LaosLaser/AddOns/i2c-panel/pictures/panel-laos-hardware.png

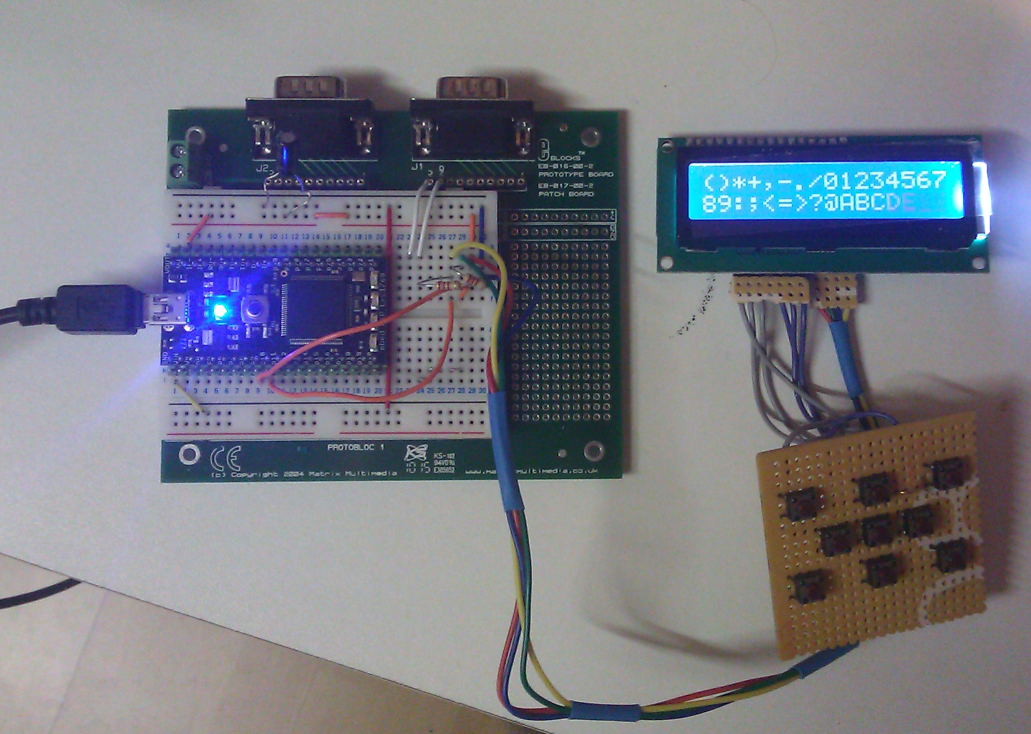
i2c-panel/pictures/panel-laos-hardware.png
