LaosLaser/AddOns/i2c-panel/Datasheets/ATTiny2313/schematic.jpg

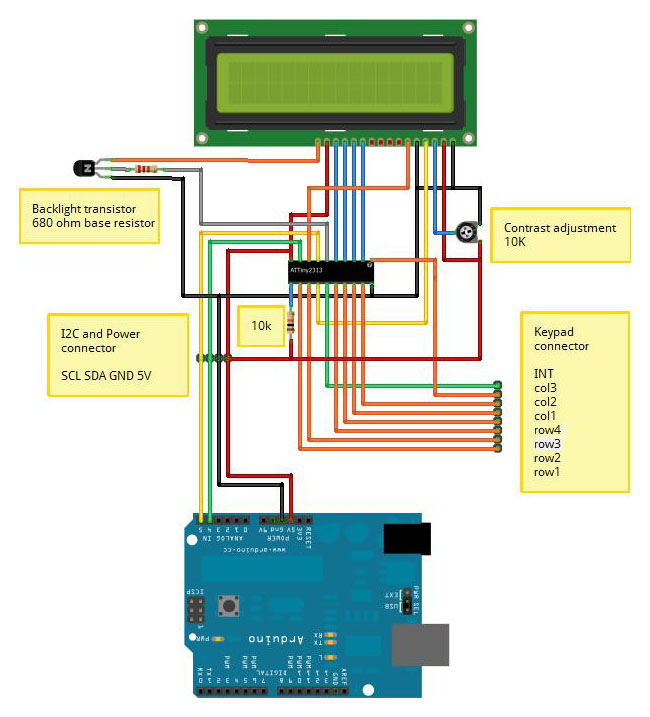
i2c-panel/Datasheets/ATTiny2313/schematic.jpg
