LaosLaser/AddOns/i2c-panel/firmware/README.txt

In this directory:

I2C-panel-test.cpp		Test program for I2C communication from
				MBED to Arduino and vice-versa.
				The MBED is master.
lasercutterpanel.pde		Arduino program implementing:
				* I2C slave
				* 16x2 LCD
				* 6 Button keyboard
				Getest op Arduino Duemilanove
