LaosLaser/AddOns/i2c-panel/pcb-0.4/production/PI_E545252.pdf

E545252 PCB view TOP (topview)

E545252 TOP layer Image (topview)

E545252 BOTTOM layer Image (topview)

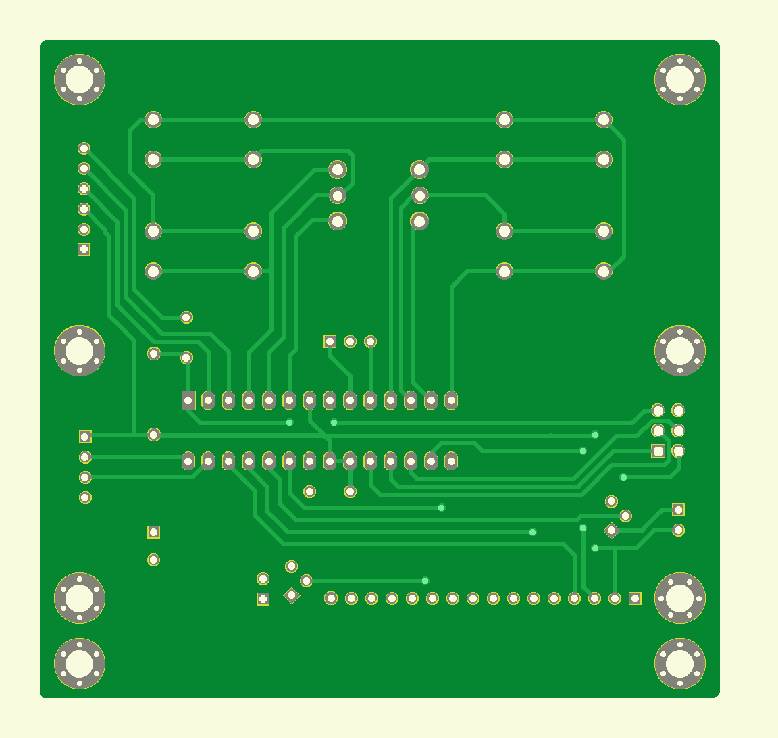
[picture p3: page 4]

E545252 PCB view BOTTOM (bottomview)

# E545252 PCB Mechanical view (topview)

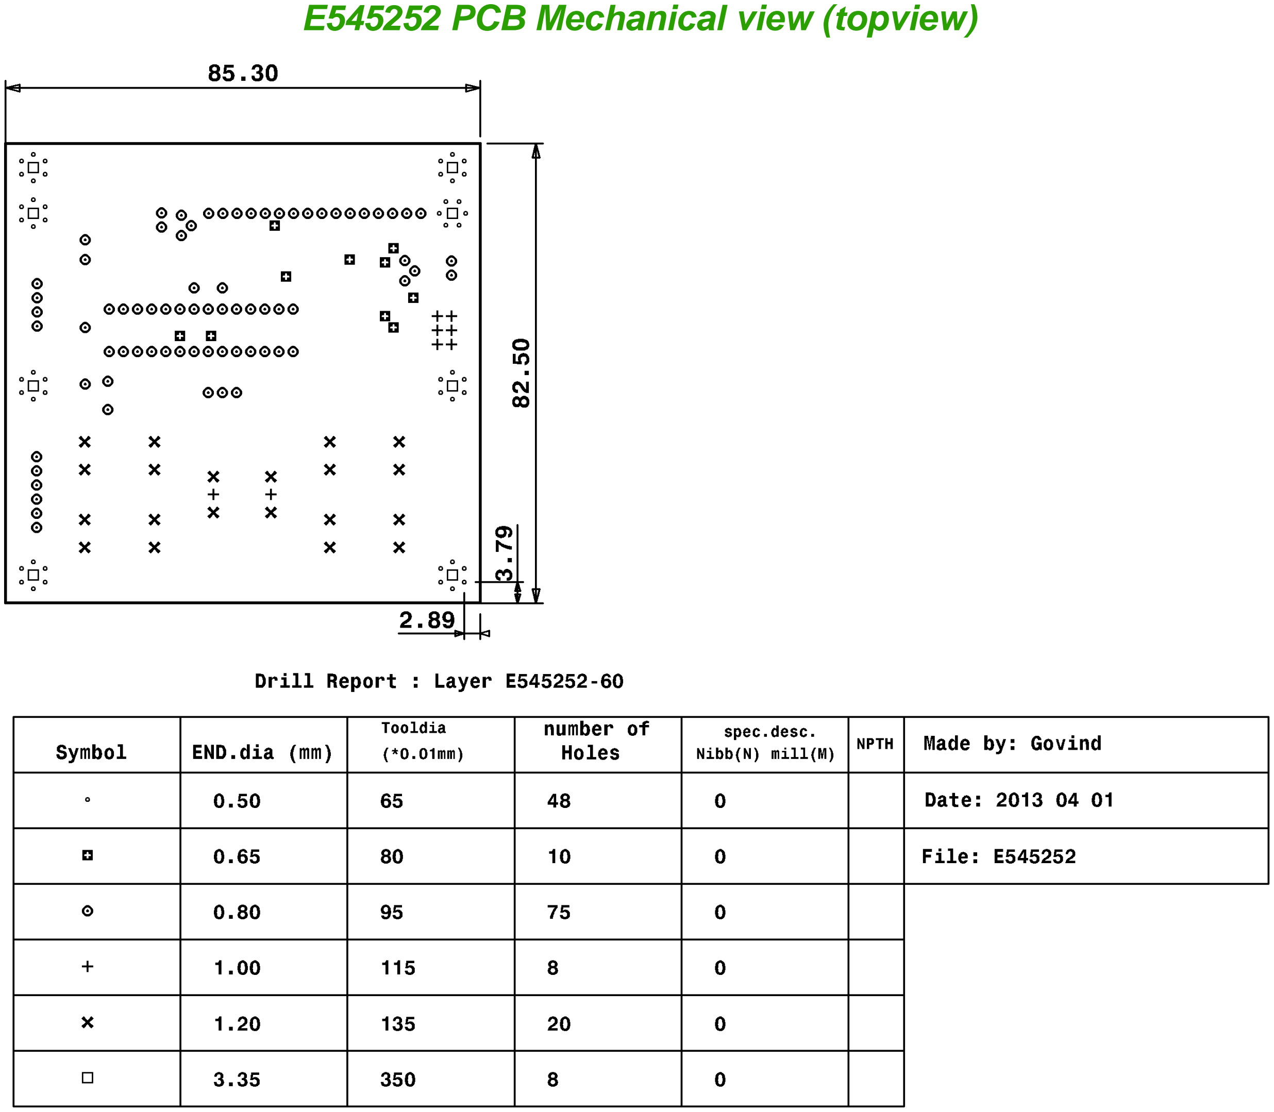
[picture p4: page 5]
