LaosLaser/AddOns/i2c-panel/pictures/panel-2011-07-01.jpg

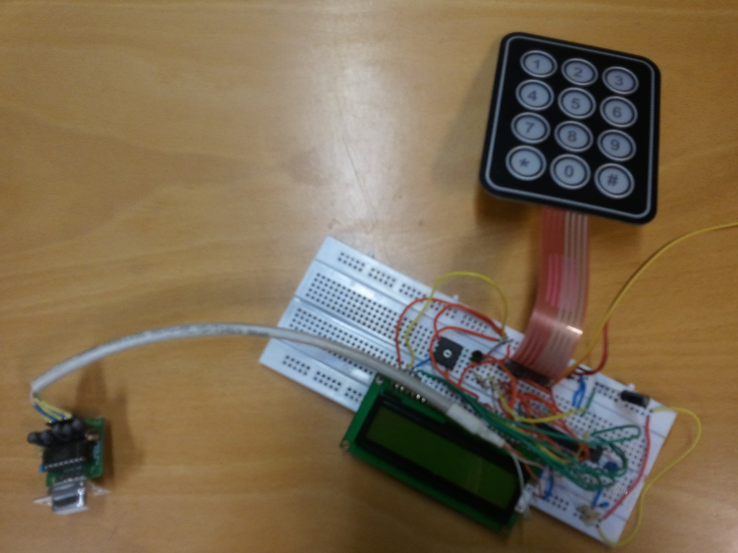
i2c-panel/pictures/panel-2011-07-01.jpg
