LaosLaser/AddOns/i2c-panel/pictures/panel-2011-07.jpg

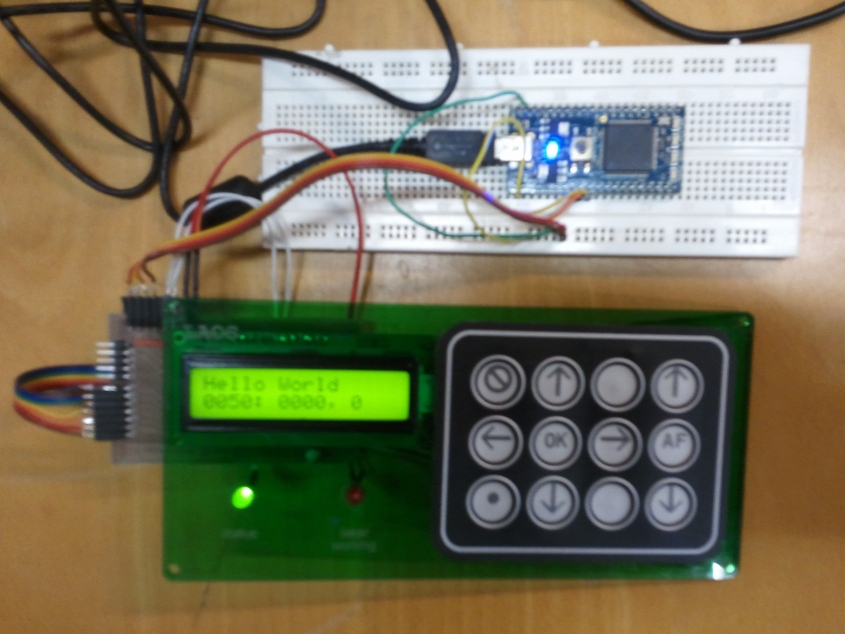
i2c-panel/pictures/panel-2011-07.jpg
