LaosLaser/AddOns/i2c-panel/pictures/panel-epilog.jpg

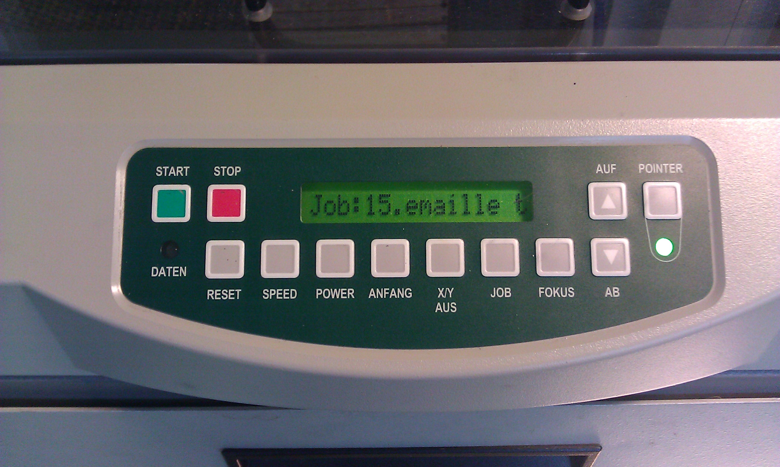
i2c-panel/pictures/panel-epilog.jpg
