LaosLaser/AddOns/i2c-panel/pictures/panel-hpc.jpg

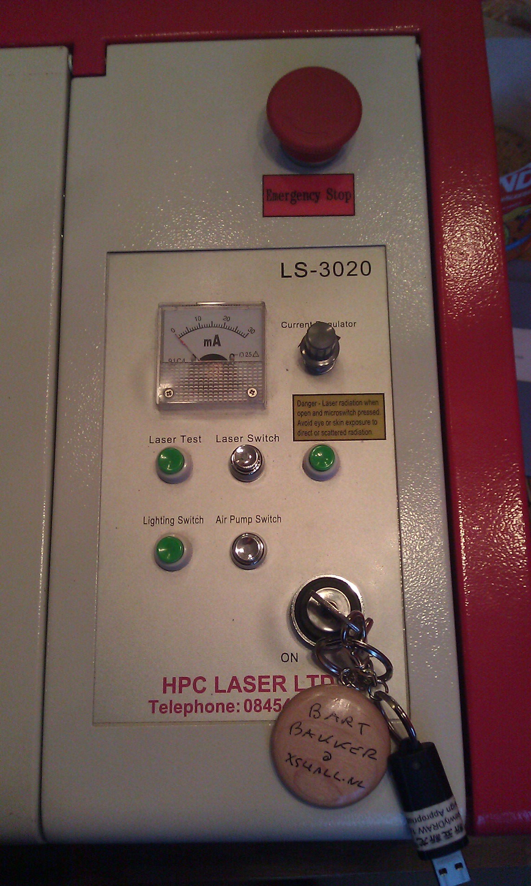
i2c-panel/pictures/panel-hpc.jpg
