LaosLaser/AddOns/i2c-panel/pictures/panel-laos.png

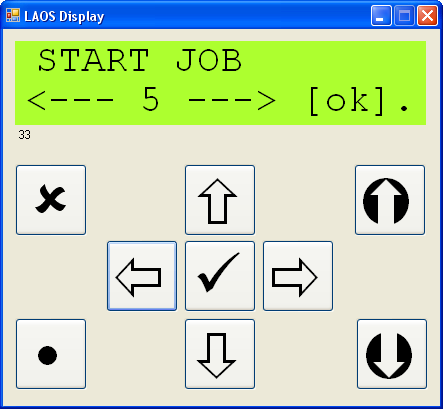
i2c-panel/pictures/panel-laos.png
