LaosLaser/AddOns/i2c-panel/pictures/panel-rev0.2.png

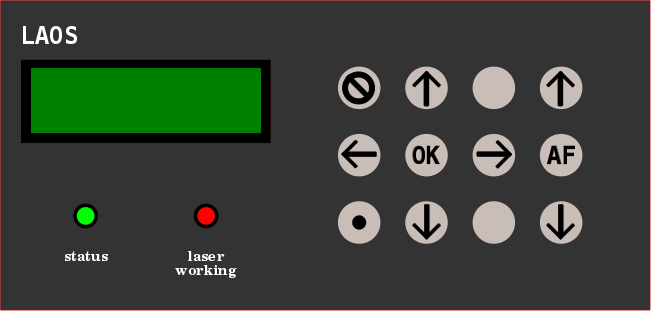
i2c-panel/pictures/panel-rev0.2.png
