LaosLaser/AddOns/i2c-panel/pictures/panel-spiritgx.jpg

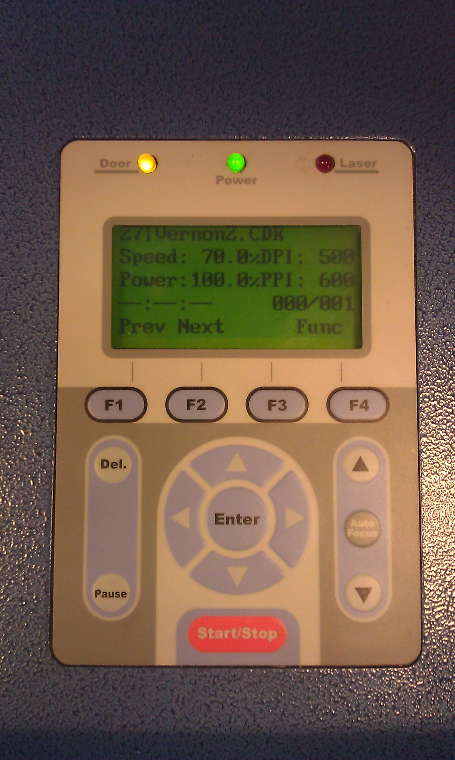
i2c-panel/pictures/panel-spiritgx.jpg
