LaosLaser/AddOns/i2c-panel/pictures/panel-suda.jpg

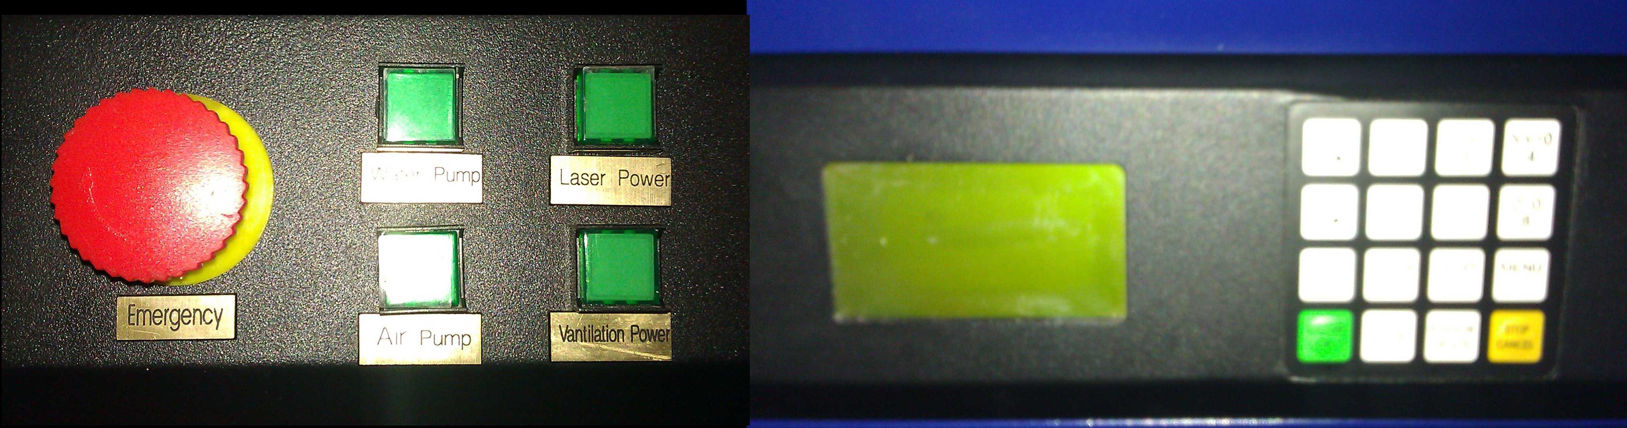
i2c-panel/pictures/panel-suda.jpg
