LaosLaser/AddOns/i2c-panel/pictures/rev0.3_prototype/IMG_20111130_150810.jpg

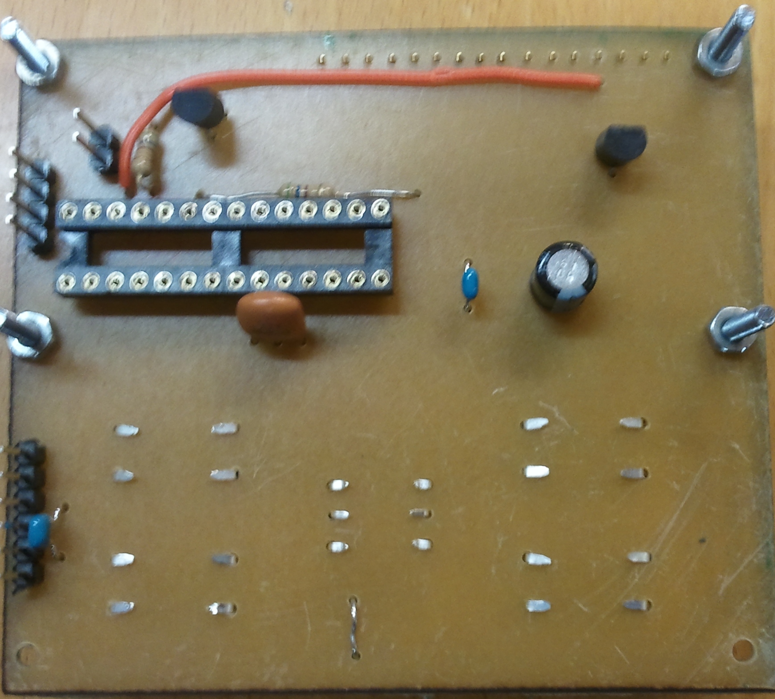
i2c-panel/pictures/rev0.3_prototype/IMG_20111130_150810.jpg
