LaosLaser/AddOns/i2c-panel/pcb-0.4/bom.ods

# | Bill of materials, I2C Panel rev0.4 | Part | Shop | Order nr | PPS | Tot
1 | LCD display, 16x2 characters | U3 | RS Components | 532-6408 | 4.62 | 4.62
1 | ATMega168P-20PU | IC1 | RS Components | 738-0375 | 5.22 | 5.22 | Farnell: 1661728: 2,45/stuk!
4 | Thru hole tactileswitch12x12x7.3mm | SW1-4 | RS Components | 378-6763 | 0.46 | 1.84
1 | PCB Stick switch, 4 dir + centre push | SW5 | RS Components | 516-316 | 2.25 | 2.25
1 | Ceramic resonator THT CSTLS 16.00MHz | F1 | RS Components | 526-6154 | 0.56 | 0.56
1 | 28way low profile DIL socket,0.3in pitch | IC1 | RS Components | 801-768 | 0.24 | 0.24
2 | 100uF capacitor | U2 | RS Components | 711-0703 | 0.03 | 0.06
2 | 100nF capacitor | U1,U4 | RS Components | 721-5240 | 0.07 | 0.14
1 | 10K resistor | R2 | RS Components | 707-7745 | 0.02 | 0.02
1 | 36 way straight header,7mm top 3mm below |  | RS Components | 251-8632 | 0.31 | 0.31
2 | BS270 | Q1, Q4 | Farnell | 1017689 | 0.149 | 0.298
1 | Kingstate KPEG242 buzzer | P3 | Farnell | 1502726 | 2.03 | 2.03 | of RS: 535-8253
3 | plastic buttoncap black |  | RS Components | 378-6943 | 0.11 | 0.33
1 | plastic buttoncap red |  | RS Components | 378-6937 | 0.11 | 0.11
1 | Eurocircuits PCB |  | Eurocircuits | E412106 | 7.5 | 7.5
 |  |  |  |  |  | 25.528
 | BTW |  |  |  |  | 30.88888
