LaosLaser/AddOns/i2c-panel/pcb-0.4/panel.sch

## KiCad design i2c-panel/pcb-0.4/panel.sch (2013-04-17)

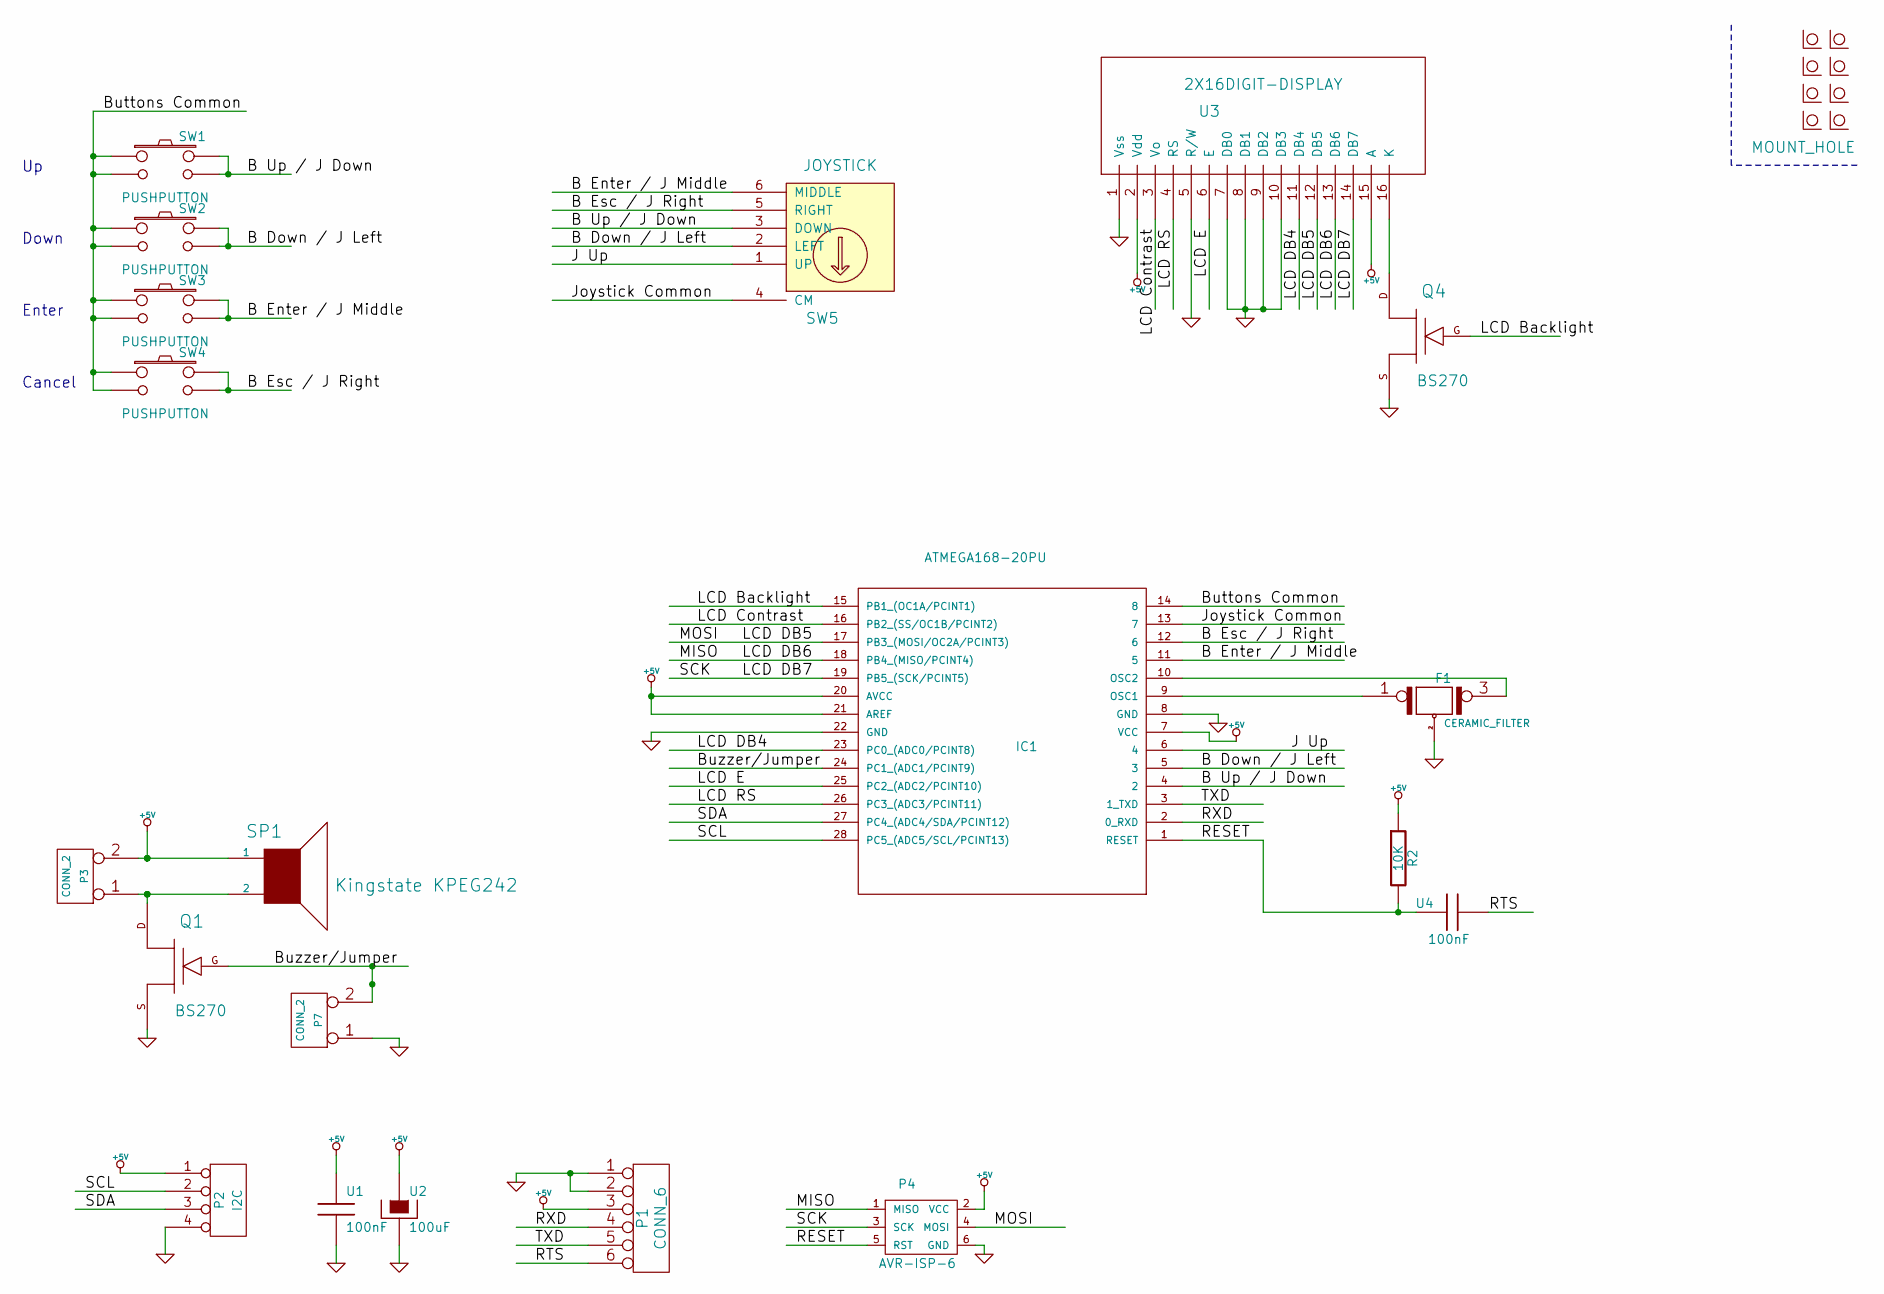
[picture p17: schematic panel.sch]

Parts:
F1: CERAMIC_FILTER; SIL-3
H1, H2, H3, H4, H5, H6, H7, H8: MOUNT_HOLE; HOLE_3MM
IC1: ATMEGA168-20PU; DIP-28__300_ELL
P1: CONN_6; SIL-6
P2: I2C; SIL-4
P3: CONN_2; SIL-1
P4: AVR-ISP-6; SIL-1
P7: CONN_2; SIL-2
Q1, Q4: BS270; TO92DGS
R2: 10K; R4
SP1: Kingstate KPEG242; KPEG242
SW1, SW2, SW3, SW4: PUSHPUTTON; PUSHBUTTON
SW5: JOYSTICK; JOYSTICK_FLIPPED_RIGHT
U1, U4: 100nF; C2
U2: 100uF; CCAP_3.5MM
U3: 2X16DIGIT-DISPLAY; SIL-16

Connections:
+5V: IC1.7 (VCC), IC1.20 (AVCC), IC1.21 (AREF), P1.3, P2.1, P3.2 (PM), P4.2 (VCC), R2.1, SP1.1, U1.1, U2.1, U3.2 (Vdd), U3.15 (A)
B Down / J Left: IC1.5 (3), SW2.3, SW2.4, SW5.2 (LEFT)
B Enter / J Middle: IC1.11 (5), SW3.3, SW3.4, SW5.6 (MIDDLE)
B Esc / J Right: IC1.12 (6), SW4.3, SW4.4, SW5.5 (RIGHT)
B Up / J Down: IC1.4 (2), SW1.3, SW1.4, SW5.3 (DOWN)
Buttons Common: IC1.14 (8), SW1.1, SW1.2, SW2.1, SW2.2, SW3.1, SW3.2, SW4.1, SW4.2
Buzzer/Jumper: IC1.24 (PC1_(ADC1/PCINT9)), P7.2 (PM), Q1.G
GND: F1.2 (PM), IC1.8 (GND), IC1.22 (GND), P1.1, P1.2, P2.4, P4.6 (GND), P7.1, Q1.S, Q4.S, U1.2, U2.2, U3.1 (Vss), U3.5 (R/W), U3.7 (DB0), U3.8 (DB1), U3.9 (DB2), U3.10 (DB3)
J Up: IC1.6 (4), SW5.1 (UP)
Joystick Common: IC1.13 (7), SW5.4 (CM)
LCD Backlight: IC1.15 (PB1_(OC1A/PCINT1)), Q4.G
LCD Contrast: IC1.16 (PB2_(SS/OC1B/PCINT2)), U3.3 (Vo)
LCD DB4: IC1.23 (PC0_(ADC0/PCINT8)), U3.11 (DB4)
LCD DB5: IC1.17 (PB3_(MOSI/OC2A/PCINT3)), P4.4 (MOSI), U3.12 (DB5)
LCD DB6: IC1.18 (PB4_(MISO/PCINT4)), P4.1 (MISO), U3.13 (DB6)
LCD DB7: IC1.19 (PB5_(SCK/PCINT5)), P4.3 (SCK), U3.14 (DB7)
LCD E: IC1.25 (PC2_(ADC2/PCINT10)), U3.6 (E)
LCD RS: IC1.26 (PC3_(ADC3/PCINT11)), U3.4 (RS)
unnamed: F1.1, IC1.9 (OSC1)
unnamed: F1.3, IC1.10 (OSC2)
unnamed: P3.1, Q1.D, SP1.2
unnamed: Q4.D, U3.16 (K)
RESET: IC1.1 (RESET), P4.5 (RST), R2.2, U4.1
RTS: P1.6, U4.2
RXD: IC1.2 (0_RXD), P1.4
SCL: IC1.28 (PC5_(ADC5/SCL/PCINT13)), P2.2
SDA: IC1.27 (PC4_(ADC4/SDA/PCINT12)), P2.3
TXD: IC1.3 (1_TXD), P1.5

Notes on the sheet:
Down
Enter
Cancel
