LaosLaser/AddOns/i2c-panel/pcb/panel.sch

## KiCad design i2c-panel/pcb/panel.sch (2011-12-03, an earlier design)

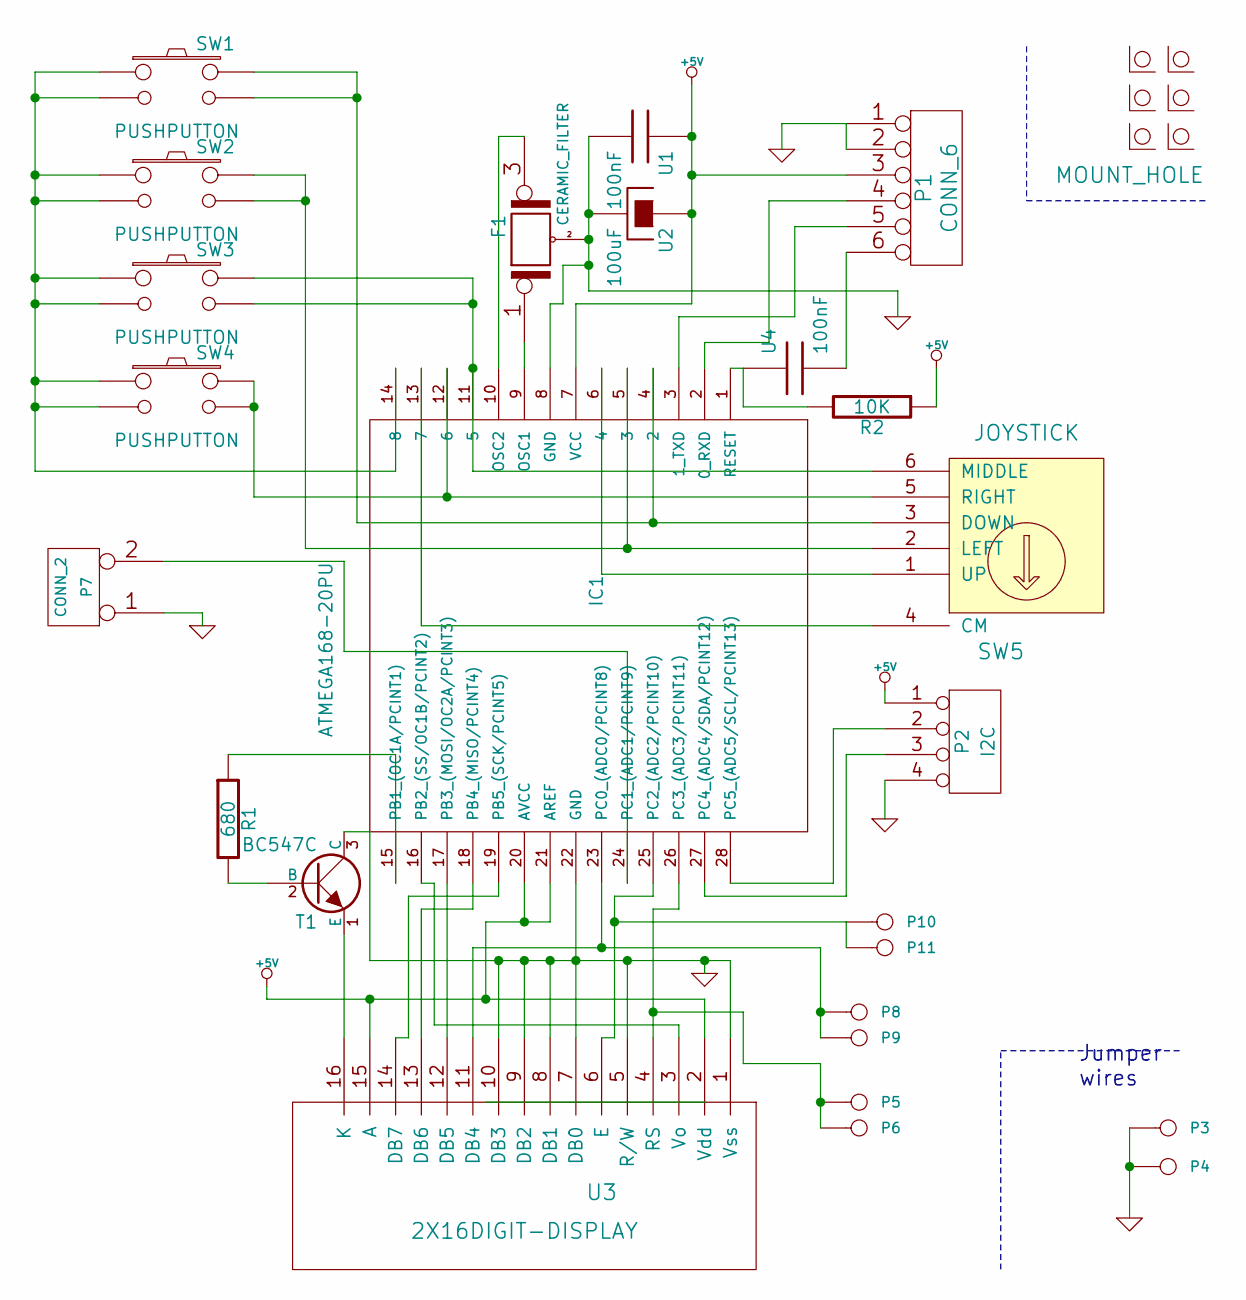
[picture p18: schematic panel.sch]

Parts:
F1: CERAMIC_FILTER
H1, H2, H3, H4, H5, H6: MOUNT_HOLE
IC1: ATMEGA168-20PU; MLF44
P1: CONN_6
P2: I2C
P3, P4, P5, P6, P8, P9, P10, P11: CONN_1
P7: CONN_2
R1: 680
R2: 10K
SW1, SW2, SW3, SW4: PUSHPUTTON
SW5: JOYSTICK
T1: BC547C
U1, U4: 100nF
U2: 100uF
U3: 2X16DIGIT-DISPLAY

Connections:
+5V: IC1.7 (VCC), IC1.20 (AVCC), IC1.21 (AREF), P1.3, P2.1, R2.1, U1.1, U2.1, U3.2 (Vdd), U3.15 (A)
GND: F1.2 (PM), IC1.8 (GND), IC1.22 (GND), P1.1, P1.2, P2.4, P3.1, P4.1, P7.1, T1.3 (C), U1.2, U2.2, U3.1 (Vss), U3.5 (R/W), U3.7 (DB0), U3.8 (DB1), U3.9 (DB2), U3.10 (DB3)
unnamed: F1.1, IC1.9 (OSC1)
unnamed: F1.3, IC1.10 (OSC2)
unnamed: IC1.1 (RESET), R2.2, U4.1
unnamed: IC1.2 (0_RXD), P1.4
unnamed: IC1.3 (1_TXD), P1.5
unnamed: IC1.4 (2), SW1.3, SW1.4, SW5.3 (DOWN)
unnamed: IC1.5 (3), SW2.3, SW2.4, SW5.2 (LEFT)
unnamed: IC1.6 (4), SW5.1 (UP)
unnamed: IC1.11 (5), SW3.3, SW3.4, SW5.6 (MIDDLE)
unnamed: IC1.12 (6), SW4.3, SW4.4, SW5.5 (RIGHT)
unnamed: IC1.13 (7), SW5.4 (CM)
unnamed: IC1.14 (8), SW1.1, SW1.2, SW2.1, SW2.2, SW3.1, SW3.2, SW4.1, SW4.2
unnamed: IC1.15 (PB1_(OC1A/PCINT1)), R1.1
unnamed: IC1.16 (PB2_(SS/OC1B/PCINT2)), U3.3 (Vo)
unnamed: IC1.17 (PB3_(MOSI/OC2A/PCINT3)), U3.12 (DB5)
unnamed: IC1.18 (PB4_(MISO/PCINT4)), U3.13 (DB6)
unnamed: IC1.19 (PB5_(SCK/PCINT5)), U3.14 (DB7)
unnamed: IC1.23 (PC0_(ADC0/PCINT8)), P8.1, P9.1, U3.11 (DB4)
unnamed: IC1.24 (PC1_(ADC1/PCINT9)), P7.2 (PM)
unnamed: IC1.25 (PC2_(ADC2/PCINT10)), P10.1, P11.1, U3.6 (E)
unnamed: IC1.26 (PC3_(ADC3/PCINT11)), P5.1, P6.1, U3.4 (RS)
unnamed: IC1.27 (PC4_(ADC4/SDA/PCINT12)), P2.3
unnamed: IC1.28 (PC5_(ADC5/SCL/PCINT13)), P2.2
unnamed: P1.6, U4.2
unnamed: R1.2, T1.2 (B)
unnamed: T1.1 (E), U3.16 (K)

Notes on the sheet:
Jumper wires
