LaosLaser/AddOns/i2c-panel/Datasheets/ATTiny2313/HD4470LCD/wiring.c

/*
  wiring.c - Partial implementation of the Wiring API for the ATmega8.
  Part of Arduino - http://www.arduino.cc/

  Copyright (c) 2005-2006 David A. Mellis

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
  $Id: wiring.c 539 2008-12-23 00:17:14Z mellis $
  
  modified for Atmel ATTiny2313 mcu by René Bohne

  5 February 2010 modified by John Crouchley for I2C LCD controller
*/

#include "wiring_private.h"
#include "Keyboard.h"

volatile unsigned long timer0_overflow_count = 0;
volatile unsigned long timer0_clock_cycles = 0;
volatile unsigned long timer0_millis = 0;

SIGNAL(TIMER0_OVF_vect)
{
	timer0_overflow_count++;
	// timer 0 prescale factor is 64 and the timer overflows at 256
	timer0_clock_cycles += 64UL * 256UL;
	while (timer0_clock_cycles > clockCyclesPerMicrosecond() * 1000UL) {
		timer0_clock_cycles -= clockCyclesPerMicrosecond() * 1000UL;
		timer0_millis++;
		scanKeyb();
	}
}

unsigned long millis()
{
	unsigned long m;
	uint8_t oldSREG = SREG;
	
	// disable interrupts while we read timer0_millis or we might get an
	// inconsistent value (e.g. in the middle of the timer0_millis++)
	cli();
	m = timer0_millis;
	SREG = oldSREG;
	
	return m;
}

/*
unsigned long micros() {
	unsigned long m, t;
	uint8_t oldSREG = SREG;
	
	cli();	
	t = TCNT0;
  
#ifdef TIFR0
	if ((TIFR0 & _BV(TOV0)) && (t == 0))
		t = 256;
#else
	if ((TIFR & _BV(TOV0)) && (t == 0))
		t = 256;
#endif

	m = timer0_overflow_count;
	SREG = oldSREG;
	
	return ((m << 8) + t) * (64 / clockCyclesPerMicrosecond());
}
*/

void delay(unsigned long ms)
{
	unsigned long start = millis();
	
	while (millis() - start <= ms)
		;
}

/* Delay for the given number of microseconds.  Assumes a 8 or 16 MHz clock. 
 * Disables interrupts, which will disrupt the millis() function if used
 * too frequently. */
void delayMicroseconds(unsigned int us)
{
	uint8_t oldSREG;

	// calling avrlib's delay_us() function with low values (e.g. 1 or
	// 2 microseconds) gives delays longer than desired.
	//delay_us(us);

#if F_CPU >= 16000000L
	// for the 16 MHz clock on most Arduino boards

	// for a one-microsecond delay, simply return.  the overhead
	// of the function call yields a delay of approximately 1 1/8 us.
	if (--us == 0)
		return;

	// the following loop takes a quarter of a microsecond (4 cycles)
	// per iteration, so execute it four times for each microsecond of
	// delay requested.
	us <<= 2;

	// account for the time taken in the preceeding commands.
	us -= 2;
#else
	// for the 8 MHz internal clock on the ATmega168

	// for a one- or two-microsecond delay, simply return.  the overhead of
	// the function calls takes more than two microseconds.  can't just
	// subtract two, since us is unsigned; we'd overflow.
	if (--us == 0)
		return;
	if (--us == 0)
		return;

	// the following loop takes half of a microsecond (4 cycles)
	// per iteration, so execute it twice for each microsecond of
	// delay requested.
	us <<= 1;
    
	// partially compensate for the time taken by the preceeding commands.
	// we can't subtract any more than this or we'd overflow w/ small delays.
	us--;
#endif

	// disable interrupts, otherwise the timer 0 overflow interrupt that
	// tracks milliseconds will make us delay longer than we want.
	oldSREG = SREG;
	cli();

	// busy wait
	__asm__ __volatile__ (
		"1: sbiw %0,1" "\n\t" // 2 cycles
		"brne 1b" : "=w" (us) : "0" (us) // 2 cycles
	);

	// reenable interrupts.
	SREG = oldSREG;
}

void init()
{
	// this needs to be called before setup() or some functions won't
	// work there
	//sei();
	
	// on the ATtiny2313, timer 0 is also used for fast hardware pwm
	// (using phase-correct PWM would mean that timer 0 overflowed half as often
	// resulting in different millis() behavior on the ATmega8 and ATtiny2313)

	sbi(TCCR0A, WGM01);
	sbi(TCCR0A, WGM00);


	// set timer 0 prescale factor to 64
	sbi(TCCR0B, CS01);
	sbi(TCCR0B, CS00);


	sbi(TIMSK, TOIE0);


	// timers 1 is used for phase-correct hardware pwm
	// this is better for motors as it ensures an even waveform
	// note, however, that fast pwm mode can achieve a frequency of up
	// 8 MHz (with a 16 MHz clock) at 50% duty cycle

	// set timer 1 prescale factor to 64
	////sbi(TCCR1B, CS11);
	////sbi(TCCR1B, CS10);
	// put timer 1 in 8-bit phase correct pwm mode
	////sbi(TCCR1A, WGM10);



	// the bootloader connects pins 0 and 1 to the USART; disconnect them
	// here so they can be used as normal digital i/o; they will be
	// reconnected in Serial.begin()

	////UCSRB = 0;
}
