LaosLaser/AddOns/i2c-panel/Datasheets/ATTiny2313/HD4470LCD/wiring.h

/*
  wiring.h - Partial implementation of the Wiring API for the ATmega8.
  Part of Arduino - http://www.arduino.cc/

  Copyright (c) 2005-2006 David A. Mellis

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
  $Id: wiring.h 534 2008-11-26 14:14:59Z mellis $
  5 February 2010 modified by John Crouchley for I2C LCD controller
*/

#ifndef Wiring_h
#define Wiring_h

#define F_CPU 8000000UL //Define the speed the clock is running at.  Used for the delay.h functions

#include <avr/io.h>
#include "binary.h"

#ifdef __cplusplus
extern "C"{
#endif

#define HIGH 0x1
#define LOW  0x0

#define INPUT 0x0
#define OUTPUT 0x1

#ifndef true
#define true 0x1
#define false 0x0
#endif

#define PI 3.14159265
#define HALF_PI 1.57079
#define TWO_PI 6.283185
#define DEG_TO_RAD 0.01745329
#define RAD_TO_DEG 57.2957786

#define SERIAL  0x0
#define DISPLAY 0x1

#define LSBFIRST 0
#define MSBFIRST 1

#define CHANGE 1
#define FALLING 2
#define RISING 3

#define INTERNAL 3
#define DEFAULT 1
#define EXTERNAL 0

// undefine stdlib's abs if encountered
#ifdef abs
#undef abs
#endif

#define min(a,b) ((a)<(b)?(a):(b))
#define max(a,b) ((a)>(b)?(a):(b))
#define abs(x) ((x)>0?(x):-(x))
#define constrain(amt,low,high) ((amt)<(low)?(low):((amt)>(high)?(high):(amt)))
#define round(x)     ((x)>=0?(long)((x)+0.5):(long)((x)-0.5))
#define radians(deg) ((deg)*DEG_TO_RAD)
#define degrees(rad) ((rad)*RAD_TO_DEG)
#define sq(x) ((x)*(x))

#define interrupts() sei()
#define noInterrupts() cli()

#define clockCyclesPerMicrosecond() ( F_CPU / 1000000L )
#define clockCyclesToMicroseconds(a) ( (a) / clockCyclesPerMicrosecond() )
#define microsecondsToClockCycles(a) ( (a) * clockCyclesPerMicrosecond() )

#define lowByte(w) ((w) & 0xff)
#define highByte(w) ((w) >> 8)

#define bitRead(value, bit) (((value) >> (bit)) & 0x01)
#define bitSet(value, bit) ((value) |= (1UL << (bit)))
#define bitClear(value, bit) ((value) &= ~(1UL << (bit)))
#define bitWrite(value, bit, bitvalue) (bitvalue ? bitSet(value, bit) : bitClear(value, bit))

typedef unsigned int word;

#define bit(b) (1 << (b))

typedef uint8_t boolean;
typedef uint8_t byte;

void init(void);

unsigned long millis(void);
unsigned long micros(void);
void delay(unsigned long);
void delayMicroseconds(unsigned int us);


#ifdef __cplusplus
} // extern "C"
#endif

#endif
