LaosLaser/AddOns/(commit log)

2011-01-29 i2c control panel for controller
2011-01-29 datasheets for i2c panel
2011-01-29 and another databasheet for the i2c panel!
2011-01-30 firmware for home-made I2C panel, based on arduino
2011-02-25 added various control panels of different laser systems
2011-06-28 datasheets for building your own i2c keyboard/display
2011-07-01 arduino panel code updates
2011-07-01 versie aan 't eind van de middag, werkt met code van peter
2011-07-01 First version of the PCB for a panel.
    As tested with Peter on juli 2nd, 2011.
    Note that during the making of the schematics, some (lots of) wires
    were moved so the code in lasercutterpanel.pde had to be adapted
    Also, the option to drive two leds has been added to the arduino code.
    However, the new wire configuration still needs to be tested before
    ordering 200+ PCB's based on this!
    [panel.sch]
2011-07-02 some improvements on panel.sch
    [panel.sch]
2011-07-02 moved some more pins around!
    [panel.sch]
2011-07-05 added lasercut & vinyl cut drawings
2011-07-12 Revision 0.2 of the PCB, with firmware for the arduino updated to a hopefully more logical pinout
    [$savepcb.brd, panel.brd, panel.dsn, panel.sch, paneldone.brd]
2011-07-12 plaatje van het panel!
2011-07-12 just cleaning up
    [panel.sch]
2011-09-19 made a box for the panel pcb, lcd and keyboard
2011-10-04 changed toggling leds to laser on/off and power on/off
2011-11-30 new i2cpanel with buttons onboard instead of external keyboard rev 0.3
    [$savepcb.brd, panel.brd, panel.sch, paneldone.brd]
2011-11-30 added bill of materials
    [panel.brd, panel.sch, partslist.ods]
2011-11-30 pictures of the prototype!
2011-11-30 small partlist updates
    [partslist.ods]
2011-12-03 some changes made after testing with the first prototype. most important: switching contrast+lcd light to pwm pins
    ==> this version was prototyped and tested before this commit!
    [panel.brd, panel.sch]
2011-12-10 updated bill of materials
    [bom.ods, panel.brd, partslist.ods]
2011-12-20 * other pwm frequency to stop interference in display * turned on welcome message on power-up
    [lasercutterpanelv0_3.pde]
2012-02-21 updated bill of materials with current prices
    [bom.ods]
2012-03-12 * forgot to commit rev0.3 layout long time ago, here it is! * and a wooden frame that fits on the front of a makerbot
2012-06-24 updated bom
    [bom.ods]
2012-09-09 moved files to subdir
    [bom.ods, panel.brd, panel.dsn, panel.sch]
2013-03-14 Rev 0.4 gemaakt: schema opgeschoond en print opnieuw gelayout
    [bom.ods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]
2013-03-18 Larger mounting holes, larger holes for SW5
    [panel.brd]
2013-03-24 I2C level converter, FET for buzzer and ISP connector added
    [bom.ods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]
2013-03-31 I2C level shifter: not neccesary, pcb enlarged for extra mounting holes
    [panel-Back.gbl, panel-Front.gtl, panel-Mask_Back.gbs, panel-Mask_Front.gts, panel-PCB_Edges.gbr, panel-SilkS_Back.gbo, panel-SilkS_Front.gto, panel-SoldP_Back.gbp]
2013-04-17 new firmware for rev0.4 pcb, with buzzer
    [lasercutterpanelv0_4.ino]
2013-04-17 Larger holes for pinheaders, extra connector for buzzer
    [panel-Back.gbl, panel-Front.gtl, panel-Mask_Back.gbs, panel-Mask_Front.gts, panel-PCB_Edges.gbr, panel-SilkS_Back.gbo, panel-SilkS_Front.gto, panel-SoldP_Back.gbp]
2013-04-17 Kingstate KPEG242 buzzer
    [panel-Back.gbl, panel-Front.gtl, panel-Mask_Back.gbs, panel-Mask_Front.gts, panel-PCB_Edges.gbr, panel-SilkS_Back.gbo, panel-SilkS_Front.gto, panel-SoldP_Back.gbp]
2013-04-17 update bom for rev0.4
    [bom.ods]
2013-11-01 svg files added
    [bom.ods]
