LaosLaser/AddOns/(notices)

Notices in the files:
i2c-panel/firmware/lasercutterpanelv0_4.ino:
LaOS is free software: you can redistribute it and/or modify
it under the terms of the GNU General Public License as published by
the Free Software Foundation, either version 3 of the License, or
(at your option) any later version.
i2c-panel/Datasheets/ATTiny2313/HD4470LCD/Keyboard.c:
This program is free software; you can redistribute it and/or modify it under the
terms of the GNU General Public License as published by the Free Software
i2c-panel/Datasheets/ATTiny2313/HD4470LCD/wiring.h:
Public License along with this library; if not, write to the
Free Software Foundation, Inc., 59 Temple Place, Suite 330,
Boston, MA 02111-1307 USA
